J93es/step-linetracer/README.md

# line-tracer
2023.summer

로봇 제원
CPU: STM32F411RET6
ROM: built in
RAM: built in
Motor Driver: SLA7026M
Motor: KH42JM2-901
ADC: built in
Sensor: IR 8조

실제 작성 코드는 Nucleo-Linetracer/Main 참조

제 24회 서울시립대 라인트레이서 경연대회 예선 (1시간 32분 ~ 1시간 37분)

https://www.youtube.com/watch?v=5ExQolZ5YAg

제 24회 서울시립대 라인트레이서 경연대회 본선 

https://www.youtube.com/watch?v=R7jy7l2zK3U
