J93es/step-linetracer/review-result/Expert-STEP 부문.pdf

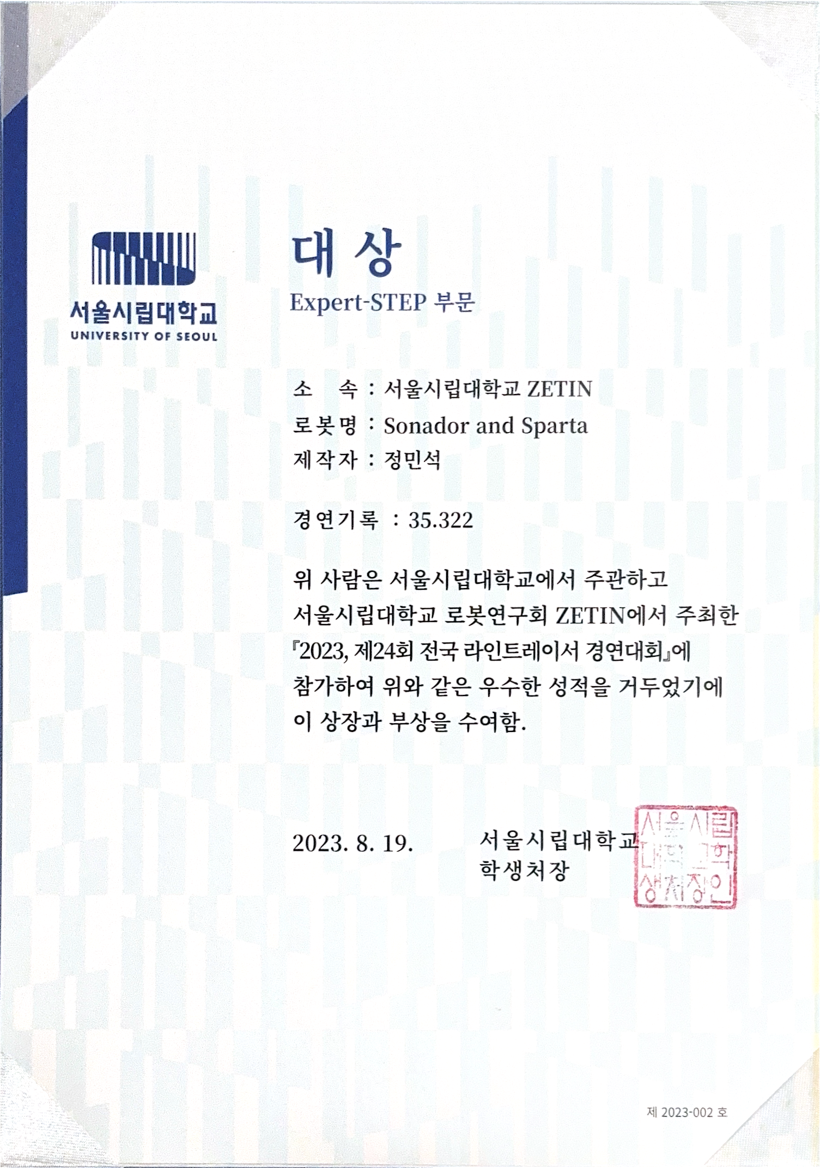
[picture p1: page 1]
