J93es/step-linetracer/template/nucleo-linetracer-template/Core/Inc/main.h

#define B1_Pin LL_GPIO_PIN_13
#define B1_GPIO_Port GPIOC
#define Sensor_Mux0_Pin LL_GPIO_PIN_0
#define Sensor_Mux0_GPIO_Port GPIOC
#define Sensor_Mux1_Pin LL_GPIO_PIN_1
#define Sensor_Mux1_GPIO_Port GPIOC
#define Sensor_Mux2_Pin LL_GPIO_PIN_2
#define Sensor_Mux2_GPIO_Port GPIOC
#define Sensor_MuxX_Pin LL_GPIO_PIN_3
#define Sensor_MuxX_GPIO_Port GPIOC
#define USART_TX_Pin LL_GPIO_PIN_2
#define USART_TX_GPIO_Port GPIOA
#define USART_RX_Pin LL_GPIO_PIN_3
#define USART_RX_GPIO_Port GPIOA
#define OLED_DC_Pin LL_GPIO_PIN_4
#define OLED_DC_GPIO_Port GPIOA
#define LD2_Pin LL_GPIO_PIN_5
#define LD2_GPIO_Port GPIOA
#define ADC_Sensor1_Pin LL_GPIO_PIN_6
#define ADC_Sensor1_GPIO_Port GPIOA
#define ADC_Sensor2_Pin LL_GPIO_PIN_7
#define ADC_Sensor2_GPIO_Port GPIOA
#define ADC_Battery_Pin LL_GPIO_PIN_0
#define ADC_Battery_GPIO_Port GPIOB
#define OLED_CS_Pin LL_GPIO_PIN_2
#define OLED_CS_GPIO_Port GPIOB
#define Motor_L1_Pin LL_GPIO_PIN_12
#define Motor_L1_GPIO_Port GPIOB
#define Motor_L3_Pin LL_GPIO_PIN_13
#define Motor_L3_GPIO_Port GPIOB
#define Motor_L4_Pin LL_GPIO_PIN_14
#define Motor_L4_GPIO_Port GPIOB
#define TMS_Pin LL_GPIO_PIN_13
#define TMS_GPIO_Port GPIOA
#define TCK_Pin LL_GPIO_PIN_14
#define TCK_GPIO_Port GPIOA
#define Motor_R1_Pin LL_GPIO_PIN_10
#define Motor_R1_GPIO_Port GPIOC
#define Motor_R3_Pin LL_GPIO_PIN_11
#define Motor_R3_GPIO_Port GPIOC
#define Motor_R4_Pin LL_GPIO_PIN_12
#define Motor_R4_GPIO_Port GPIOC
#define SWO_Pin LL_GPIO_PIN_3
#define SWO_GPIO_Port GPIOB
#define SWL_Pin LL_GPIO_PIN_4
#define SWL_GPIO_Port GPIOB
#define SWR_Pin LL_GPIO_PIN_5
#define SWR_GPIO_Port GPIOB
#define Motor_L2_Pin LL_GPIO_PIN_8
#define Motor_L2_GPIO_Port GPIOB
#define Motor_R2_Pin LL_GPIO_PIN_9
#define Motor_R2_GPIO_Port GPIOB
#define NVIC_PRIORITYGROUP_0         ((uint32_t)0x00000007) /*!< 0 bit  for pre-emption priority,
#define NVIC_PRIORITYGROUP_1         ((uint32_t)0x00000006) /*!< 1 bit  for pre-emption priority,
#define NVIC_PRIORITYGROUP_2         ((uint32_t)0x00000005) /*!< 2 bits for pre-emption priority,
#define NVIC_PRIORITYGROUP_3         ((uint32_t)0x00000004) /*!< 3 bits for pre-emption priority,
#define NVIC_PRIORITYGROUP_4         ((uint32_t)0x00000003) /*!< 4 bits for pre-emption priority,
