J93es/step-linetracer/Nucleo-Linetracer/Main/Inc/sensor.h

/*
 * sensor.h
 */

#ifndef INC_SENSOR_H_
#define INC_SENSOR_H_


#include "main.h"
#include "drive_def_var.h"


#define SWAP(a, b)				{ a ^= b; b ^= a; a ^= b; }


#define	THRESHOLD_MAX 			250
#define	THRESHOLD_MIN			20
#define	THRESHOLD_CHANGE_VAL	5
#define	THRESHOLD_INIT			100


extern volatile uint16_t	adcValue;

extern volatile uint8_t		sensorRawVals[8];
extern volatile uint8_t		midian[3];

extern volatile uint8_t		sensorNormVals[8];
extern volatile uint8_t		normalizeCoef[8];
extern volatile uint8_t		whiteMaxs[8];
extern volatile uint8_t		blackMaxs[8];

extern volatile uint8_t		state;
extern volatile uint8_t		threshold;

extern volatile uint8_t		sensorReadIdx;
extern volatile uint8_t		sensorReadIdxTable[8];

extern volatile int32_t		positionTable[8];





void	Sensor_Start();
void	Sensor_Stop();
void	Sensor_Calibration();





__STATIC_INLINE uint16_t	Sensor_ADC_Read() {
	__disable_irq();
	LL_ADC_ClearFlag_EOCS(ADC1);
	LL_ADC_REG_StartConversionSWStart(ADC1);
	while (!LL_ADC_IsActiveFlag_EOCS(ADC1));
	adcValue = LL_ADC_REG_ReadConversionData12(ADC1);
	LL_ADC_ClearFlag_EOCS(ADC1);
	__enable_irq();
	return adcValue;
}




// rawValue 계산
__STATIC_INLINE void	Make_Sensor_Raw_Vals(uint8_t idx) {

	GPIOC->ODR = (GPIOC->ODR & ~0x07) | (idx) | 0x08;
	// ADC 읽기
	midian[0] = Sensor_ADC_Read() >> 4;
	midian[1] = Sensor_ADC_Read() >> 4;
	midian[2] = Sensor_ADC_Read() >> 4;

	// 선택한 IR LED 끄기
	GPIOC->ODR &= ~0x08;


	//sMux를 사용하여 다음 IR LED 및 수광 센서 선택 및 선택한 IR LED 켜기
	// 0000 {1}(XXX) == 0000 {LED}(다음 번 i)
//	GPIOC->ODR = (GPIOC->ODR & ~0x07) | ( (sensorReadIdx + 1) & 0x07 ) | 0x08;


	// 중앙값을 sensorRawVals[i]에 저장
	if (midian[0] > midian[1]) {
		SWAP(midian[0], midian[1]);
	}
	if (midian[1] > midian[2]) {
		SWAP(midian[1], midian[2]);
	}
	sensorRawVals[idx] =  midian[1];
}





// normalized value 계산
__STATIC_INLINE void	Make_Sensor_Norm_Vals(uint8_t idx) {

	if (sensorRawVals[idx] < blackMaxs[idx])
		sensorNormVals[idx] = 0;
	else if (sensorRawVals[idx] > whiteMaxs[idx])
		sensorNormVals[idx] = 255;
	else
		sensorNormVals[idx] = (255 * (sensorRawVals[idx] - blackMaxs[idx]) / normalizeCoef[idx]);


/*
	sensorNormVals[idx] = ( (255 * (sensorRawVals[idx] - blackMaxs[idx]) / normalizeCoef[idx]) \
		& ( (sensorRawVals[idx] < blackMaxs[idx]) - 0x01 )  ) \
		| ( (sensorRawVals[idx] < whiteMaxs[idx]) - 0x01 );
*/


}





// sensor state 계산
__STATIC_INLINE void	Make_Sensor_State(uint8_t idx) {

	//state = ( state & ~(0x01 << idx) ) | ( (sensorNormVals[idx] > threshold) << idx );
	if (sensorNormVals[idx] > threshold) {
		state |= 0x01 << (7 - idx);
	}
	else {
		state &= ~(0x01 << (7 - idx));
	}
}




__STATIC_INLINE void	Make_Position_Val(uint8_t curIdx) {

	if (curIdx < 7) {

		if (positionIdxMin <= curIdx && curIdx <= positionIdxMax) {

			positionSum += positionTable[curIdx] * sensorNormVals[curIdx];
			sensorNormValsSum += sensorNormVals[curIdx];
		}
	}

	// sensorReadIdx == 7
	else {

		positionVal = positionSum / (sensorNormValsSum + 1);


		positionIdxMax = 5;
		positionIdxMin = 2;

		// positionVal이 -2000보다 작거나 2000 보다 클 때
		if (ABS(positionVal) > positionTable[4]) {

			// positionVal이 -2000보다 작을 때
			if (positionVal < 0) {
				positionIdxMax = 4;
				positionIdxMin = 1;
			}
			// positionVal이 2000보다 클 때
			else {
				positionIdxMax = 6;
				positionIdxMin = 3;
			}
		}

		positionSum = 0;
		sensorNormValsSum = 0;
	}
}






__STATIC_INLINE void	Sensor_TIM5_IRQ() {

	Make_Sensor_Raw_Vals(sensorReadIdxTable[sensorReadIdx]);

	Make_Sensor_Norm_Vals(sensorReadIdxTable[sensorReadIdx]);

	Make_Sensor_State(sensorReadIdxTable[sensorReadIdx]);

	Make_Position_Val(sensorReadIdx);

	sensorReadIdx = (sensorReadIdx + 1) & 0x07;
}

//// 이전 주기에서 읽은 센서 위치에서 4개만 선별
//__STATIC_INLINE int32_t	Window_Position_Val() {
//	uint8_t	positionIdxMax = 5;
//	uint8_t	positionIdxMin = 2;
//
//	int32_t	sensorNormVal = 0;
//	int32_t	positionSum = 0;
//	int32_t	sensorNormValsSum = 1;
//
//
//	positionIdxMax = 5;
//	positionIdxMin = 2;
//
//	// positionVal이 -2000보다 작거나 2000 보다 클 때
//	if (absPositionVal > positionTable[4]) {
//
//		// positionVal이 -2000보다 작을 때
//		if (positionVal < 0) {
//			positionIdxMax = 4;
//			positionIdxMin = 1;
//		}
//		// positionVal이 2000보다 클 때
//		else {
//			positionIdxMax = 6;
//			positionIdxMin = 3;
//		}
//	}
//
//	do {
//
//		// 중간에 센서 인터럽트가 있다면 값이 바뀔 수 있음으로 별도의 변수에 저장
//		sensorNormVal = sensorNormVals[positionIdxMin];
//
//		positionSum += positionTable[positionIdxMin] * sensorNormVal;
//		sensorNormValsSum += sensorNormVal;
//
//		positionIdxMin++;
//
//	} while (positionIdxMin < positionIdxMax + 1);
//
//
//	// positionValBuffer 값 return
//	//divide by zero 방지하기 위해 sensorNormValsSum + 1로 나눔
//	return positionSum / sensorNormValsSum;
//}



#endif /* INC_SENSOR_H_ */
