J93es/step-linetracer/Nucleo-Linetracer/Main/Src/sensor.c

/*
 * sensor.c
 */

#include "header_init.h"


volatile uint16_t	adcValue;

volatile uint8_t	sensorRawVals[8];
volatile uint8_t	midian[3];

volatile uint8_t	sensorNormVals[8] = { 0, };
volatile uint8_t	normalizeCoef[8];
volatile uint8_t	whiteMaxs[8];
volatile uint8_t	blackMaxs[8];

volatile uint8_t	state = 0x00;
volatile uint8_t	threshold = THRESHOLD_INIT;

volatile uint8_t	sensorReadIdx = 0;
volatile uint8_t	sensorReadIdxTable[8] = { 3, 4, 0, 7, 1, 6, 2, 5 };

volatile int32_t	positionTable[8] = { -14000, -10000, -6000, -2000, 2000, 6000, 10000, 14000 };






void Sensor_Start() {
	LL_ADC_Enable(ADC1);
	Custom_Delay_ms(10); // ADC를 켜고 난 후, ADC 변환을 하기 전 내부 아날로그 안정화 작업을 위해 딜레이를 준다.

	LL_TIM_EnableCounter(TIM5); // TIM5의 타이머 카운터가 증가하도록 설정한다.
	LL_TIM_EnableIT_UPDATE(TIM5); // TIM5의 인터럽트가 동작하도록 설정한다. 인터럽트가 발생하면 Core/Src/stm32f4xx_it.c 파일 내부에 있는 인터럽트 핸들러 함수가 호출된다.

	Custom_Delay_ms(10); // 센서 raw 값이 생성될 때까지 기다림
}




void Sensor_Stop() {
	LL_ADC_Disable(ADC1);
	LL_TIM_DisableCounter(TIM5);
	LL_TIM_DisableIT_UPDATE(TIM5);
}





void Sensor_Calibration() {
	uint8_t	tmp = 0;

	for (uint8_t i = 0; i < 8; i++) {
		whiteMaxs[i] = 0;
		blackMaxs[i] = 0;
	}

	Sensor_Start();

	// Get blackMax
	Custom_OLED_Clear();
	while (CUSTOM_SW_BOTH != Custom_Switch_Read()) {
		Custom_OLED_Printf("/0Black Max");

		for (uint8_t i = 0; i < 8; i++) {
			if (blackMaxs[i] < (tmp = sensorRawVals[i])) {
				blackMaxs[i] = tmp;
			}
		}
		Custom_OLED_Printf("/1%2x/r%2x/w%2x/r%2x/w%2x/r%2x/w%2x/r%2x/w", \
			blackMaxs[0], blackMaxs[1], blackMaxs[2], blackMaxs[3], \
			blackMaxs[4], blackMaxs[5], blackMaxs[6], blackMaxs[7]);
	}

	// Get whiteMax
	Custom_OLED_Clear();
	while (CUSTOM_SW_BOTH != Custom_Switch_Read()) {
		Custom_OLED_Printf("/0White Max");

		for (uint8_t i = 0; i < 8; i++) {
			if (whiteMaxs[i] < (tmp = sensorRawVals[i])) {
				whiteMaxs[i] = tmp;
			}
		}
		Custom_OLED_Printf("/1%2x/r%2x/w%2x/r%2x/w%2x/r%2x/w%2x/r%2x/w", \
			whiteMaxs[0], whiteMaxs[1], whiteMaxs[2], whiteMaxs[3], \
			whiteMaxs[4], whiteMaxs[5], whiteMaxs[6], whiteMaxs[7]);
	}

	// Calculate ADC coefficients
	for (uint8_t i = 0; i < 8; i++) {
		normalizeCoef[i] = whiteMaxs[i] - blackMaxs[i];
	}

	Custom_OLED_Clear();
	Sensor_Stop();
}
