J93es/step-linetracer/Nucleo-Linetracer/Main/Inc/linetracer_test.h

/*
 * linetracer_test.h
 */

#ifndef INC_LINETRACER_TEST_H_
#define INC_LINETRACER_TEST_H_





void	Sensor_Test_Raw();
void	Sensor_Test_Normalized();
void	Sensor_Test_State();


void	Motor_Test_Velocity();
void	Motor_Test_Phase();


void	Drive_Test_Position();
void	Drive_Test_Info_Oled();

void	Current_Setting();




#endif
